DoggyArm/arucoCubeGen/images/cube_render.png

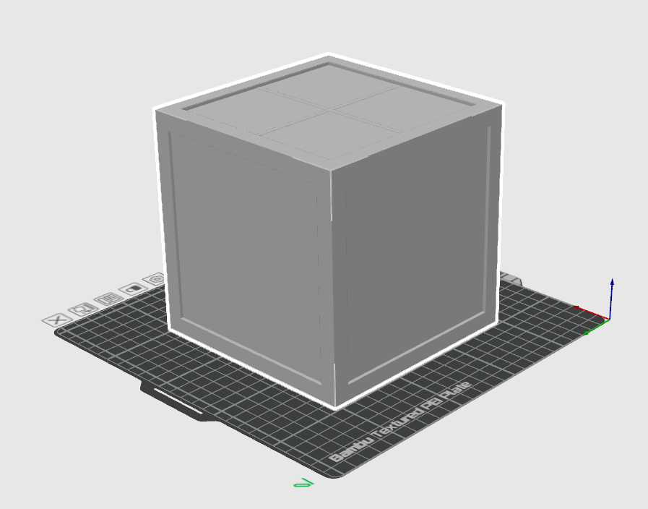
images/cube_render.png
