DoggyArm/arucoCubeGen/images/plate_render.png

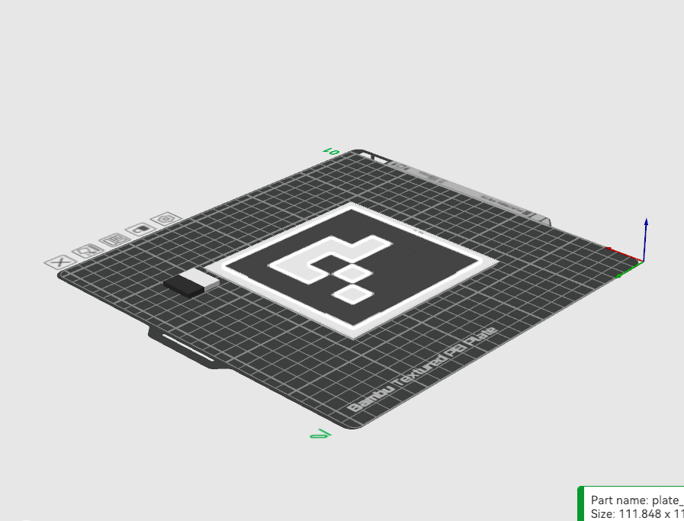
images/plate_render.png
