DoggyArm/arucoCubeGen/(commit log)

2025-12-11 added render of plate
2025-12-18 Add seam-hiding bezel to ArUco plates and tune marker layout for 1.5m detection. Adds a thin top-face bezel (flange) to overlap the cube slot opening and hide seam/shadow lines while allowing face-up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
2025-12-18 printing instructions added to readme
2025-12-18 added plate ID text
2025-12-18 Improve cube printability: chamfer slot openings and add internal roof ribs to reduce bridging
2025-12-18 attic keepout, roof stiffening, and tapered slot geometry
2025-12-24 remove top roof; add open top slot with mitered seat and gradual 45deg internal support ramp
2025-12-24 remove plate bezel and relocate ID text onto mitered plug face
